bkozan21/calico-keyboard/3d_files/README.md

# 3d files
Here you can find the STEP and STL files for the case of the keyboard. The bottom and top layer are for the left side. For the right side, you can just mirror it in the slicer you are using.

I designed everything in onshape. The document is public. You can view it here: https://cad.onshape.com/documents/db90108e0c18a49f77f814f0/w/d8d8382bf78da29ebfbabf1b/e/875cb3c507a1a049483ec79f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
