bkozan21/calico-keyboard/3d_files/top layer.step

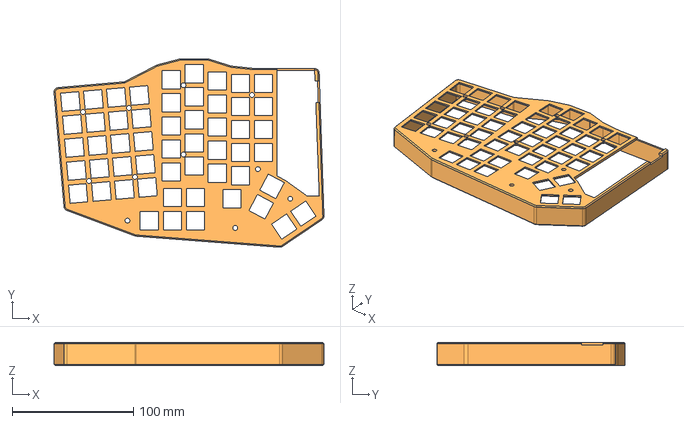
[picture p42: CAD file, 2026-11-06]
3d_files/top layer.step
222.3 x 155.2 x 19.0 mm
