bkozan21/calico-keyboard/3d_files/spacer.step

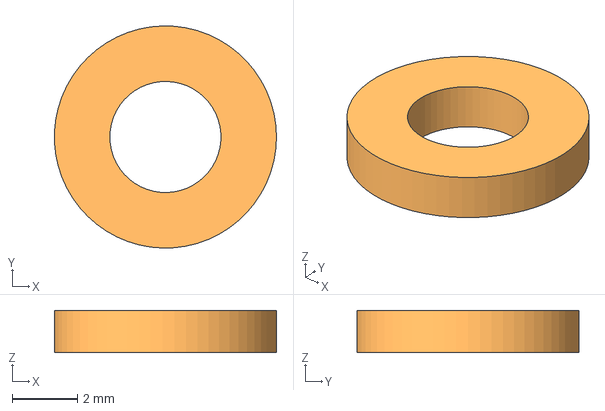
[picture p43: CAD file, 2026-11-06]
3d_files/spacer.step
6.80 x 6.80 x 1.30 mm
