bkozan21/calico-keyboard/3d_files/bottom layer.step

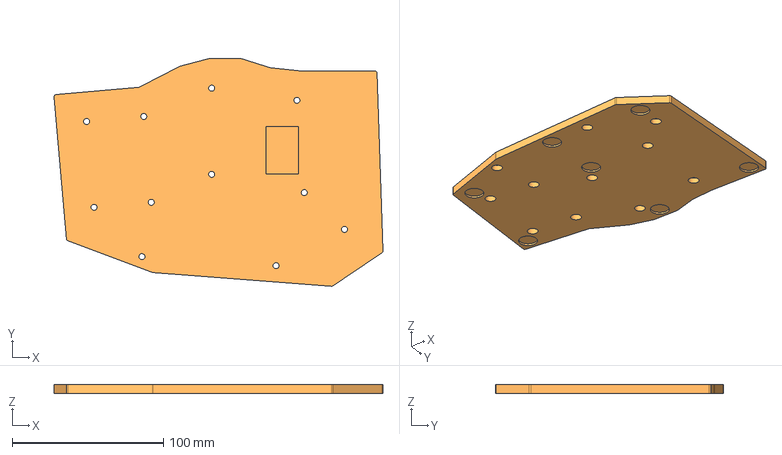
[picture p44: CAD file, 2026-11-06]
3d_files/bottom layer.step
217.7 x 150.6 x 6.00 mm
