bkozan21/calico-keyboard/(list of files, cad)

Other CAD files:
3d_files/bottom layer.stl
3d_files/spacer.stl
3d_files/top layer.stl
