bkozan21/calico-keyboard/pcb/ergogen_output.kicad_pcb

## KiCad design pcb/ergogen_output.kicad_pcb (2026-11-06)

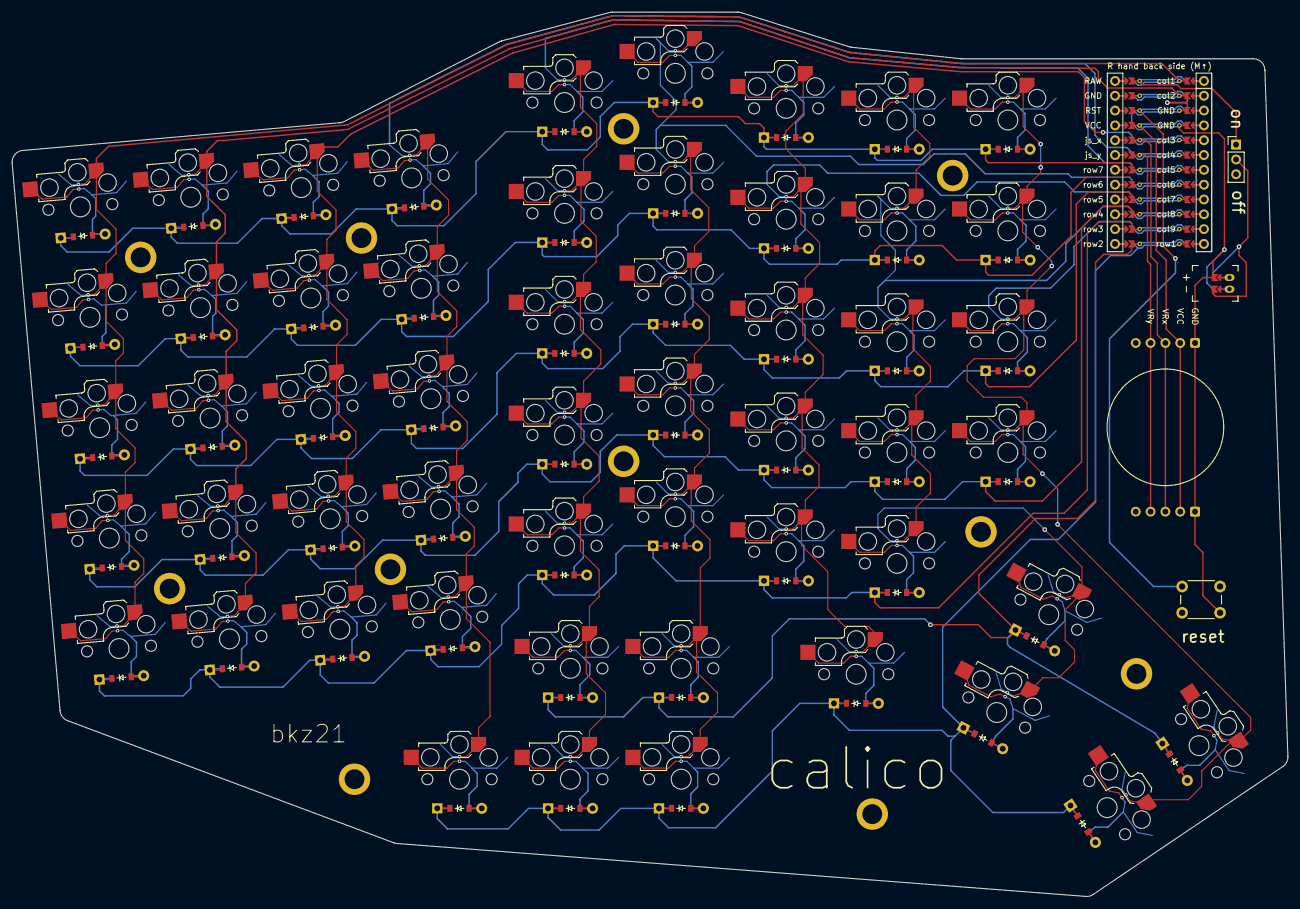
[picture p45: board ergogen_output.kicad_pcb from above]

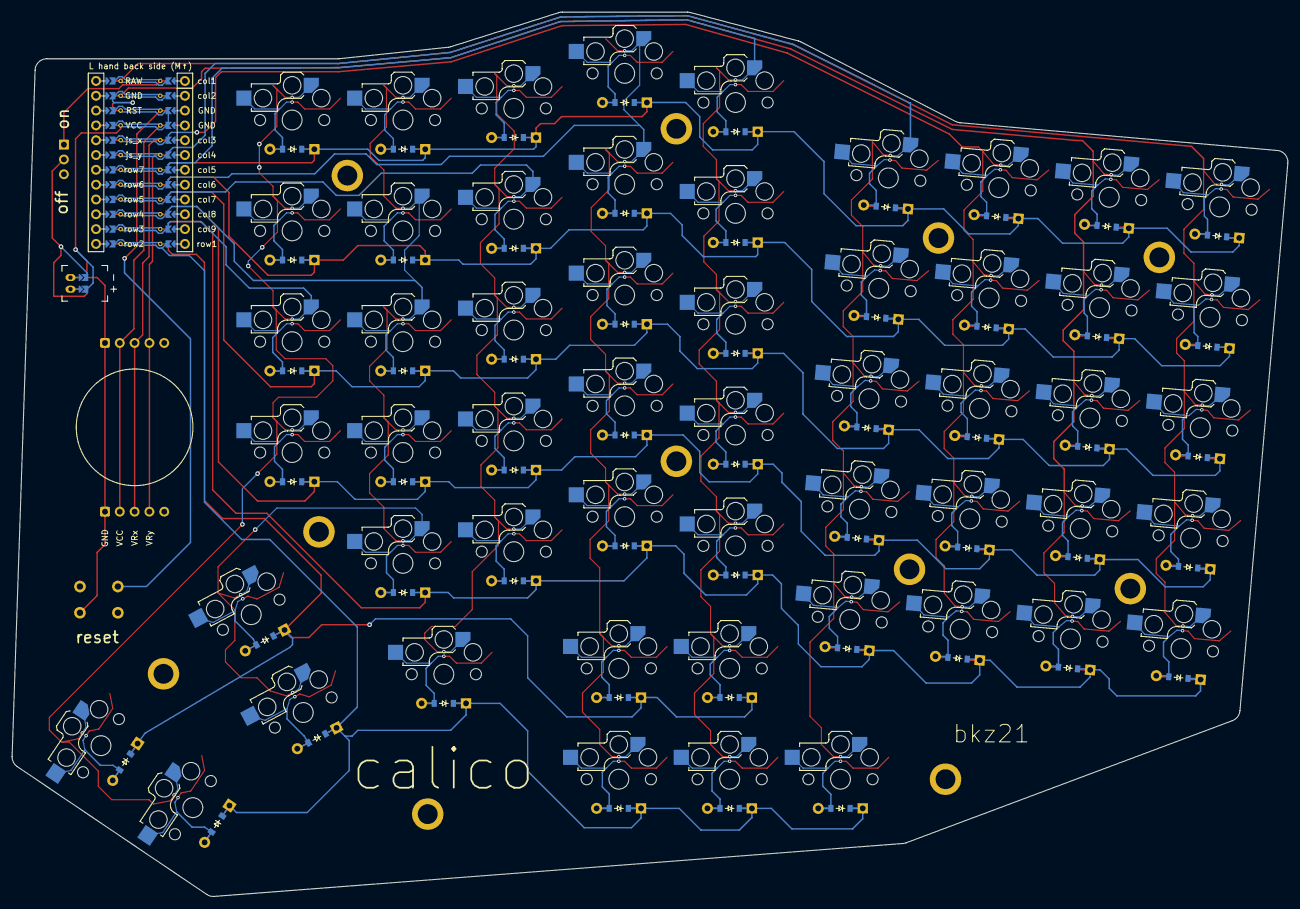
[picture p46: board ergogen_output.kicad_pcb from below]

Board: 2 copper layers, 218.7 x 151.6 mm, 121 parts (54 on the bottom side), 73 nets.

Parts:
D1, D2, D3, D4, D5, D6, D7, D8, D9, D10, D11, D12, D13, D14, D15, D16, D17, D18, D19, D20, D21, D22, D23, D24, D25, D26, D27, D28, D29, D30, D31, D32, D33, D34, D35, D36, D37, D38, D39, D40, D41, D42, D43, D44, D45, D46, D47, D48, D49, D50, D51, D52, D53, D54: diode_tht_sod123
H1, H2, H3, H4, H5, H6, H7, H8, H9, H10, H11: mounting_hole_plated
JST1: battery_connector_jst_ph_2
MCU1: mcu_nice_nano
S1, S2, S3, S4, S5, S6, S7, S8, S9, S10, S11, S12, S13, S14, S15, S16, S17, S18, S19, S20, S21, S22, S23, S24, S25, S26, S27, S28, S29, S30, S31, S32, S33, S34, S35, S36, S37, S38, S39, S40, S41, S42, S43, S44, S45, S46, S47, S48, S49, S50, S51, S52, S53, S54: switch_choc_v1_v2

Connections:
GND: JST1.1, MCU1.103, MCU1.104, MCU1.123
JST1_1: JST1.11, JST1.21, JST1.31
JST1_2: JST1.12, JST1.22, JST1.32
arrows_left_arrows_bottom: D50.2, S50.2
arrows_middle_arrows_bottom: D51.2, S51.2
arrows_middle_arrows_top: D52.2, S52.2
arrows_right_arrows_bottom: D53.2, S53.2
arrows_right_arrows_top: D54.2, S54.2
col1: MCU1.101, S1.1, S2.1, S3.1, S4.1, S5.1
col2: MCU1.102, S6.1, S7.1, S8.1, S9.1, S10.1
col3: MCU1.105, S11.1, S12.1, S13.1, S14.1, S15.1
col4: MCU1.106, S16.1, S17.1, S18.1, S19.1, S20.1, S50.1
col5: MCU1.107, S21.1, S22.1, S23.1, S24.1, S25.1, S51.1, S52.1
col6: MCU1.108, S26.1, S27.1, S28.1, S29.1, S30.1, S53.1, S54.1
col7: MCU1.109, S31.1, S32.1, S33.1, S34.1, S35.1, S45.1
col8: MCU1.110, S36.1, S37.1, S38.1, S39.1, S40.1, S46.1, S47.1
col9: MCU1.111, S41.1, S42.1, S43.1, S44.1, S48.1, S49.1
extra1_bottom: D11.2, S11.2
extra1_functions: D15.2, S15.2
extra1_home: D12.2, S12.2
extra1_numbers: D14.2, S14.2
extra1_top: D13.2, S13.2
extra2_bottom: D6.2, S6.2
extra2_functions: D10.2, S10.2
extra2_home: D7.2, S7.2
extra2_numbers: D9.2, S9.2
extra2_top: D8.2, S8.2
extra3_bottom: D1.2, S1.2
extra3_functions: D5.2, S5.2
extra3_home: D2.2, S2.2
extra3_numbers: D4.2, S4.2
extra3_top: D3.2, S3.2
far_thumb: D48.2, S48.2
far_thumb_up: D49.2, S49.2
home_thumb: D46.2, S46.2
home_thumb_up: D47.2, S47.2
index_bottom: D31.2, S31.2
index_functions: D35.2, S35.2
index_home: D32.2, S32.2
index_numbers: D34.2, S34.2
index_top: D33.2, S33.2
inner1_bottom: D36.2, S36.2
inner1_functions: D40.2, S40.2
inner1_home: D37.2, S37.2
inner1_numbers: D39.2, S39.2
inner1_top: D38.2, S38.2
inner2_functions: D44.2, S44.2
inner2_home: D41.2, S41.2
inner2_numbers: D43.2, S43.2
inner2_top: D42.2, S42.2
middle_bottom: D26.2, S26.2
middle_functions: D30.2, S30.2
middle_home: D27.2, S27.2
middle_numbers: D29.2, S29.2
middle_top: D28.2, S28.2
near_thumb: D45.2, S45.2
pinky_bottom: D16.2, S16.2
pinky_functions: D20.2, S20.2
pinky_home: D17.2, S17.2
pinky_numbers: D19.2, S19.2
pinky_top: D18.2, S18.2
ring_bottom: D21.2, S21.2
ring_functions: D25.2, S25.2
ring_home: D22.2, S22.2
ring_numbers: D24.2, S24.2
ring_top: D23.2, S23.2
row1: D45.1, D46.1, D48.1, D50.1, D51.1, D53.1, MCU1.112
row2: D47.1, D49.1, D52.1, D54.1, MCU1.113
row3: D1.1, D6.1, D11.1, D16.1, D21.1, D26.1, D31.1, D36.1, MCU1.114
row4: D2.1, D7.1, D12.1, D17.1, D22.1, D27.1, D32.1, D37.1, D41.1, MCU1.115
row5: D3.1, D8.1, D13.1, D18.1, D23.1, D28.1, D33.1, D38.1, D42.1, MCU1.116
row6: D4.1, D9.1, D14.1, D19.1, D24.1, D29.1, D34.1, D39.1, D43.1, MCU1.117
row7: D5.1, D10.1, D15.1, D20.1, D25.1, D30.1, D35.1, D40.1, D44.1, MCU1.118
