bkozan21/calico-keyboard/(commit log)

2026-11-06 added pcb files
    [ergogen_output.kicad_pcb, ergogen_output.kicad_sch]
2026-11-06 added 3d files
    [bottom layer.step, bottom layer.stl, spacer.step, spacer.stl, top layer.step, top layer.stl]
2026-11-06 added gerber files
    [ergogen_output-B_Cu.gbr, ergogen_output-B_Mask.gbr, ergogen_output-B_Paste.gbr, ergogen_output-B_Silkscreen.gbr, ergogen_output-Edge_Cuts.gbr, ergogen_output-F_Cu.gbr, ergogen_output-F_Mask.gbr, ergogen_output-F_Paste.gbr]
