bkozan21/calico-keyboard/Split Keyboard/IMG_8234.jpeg

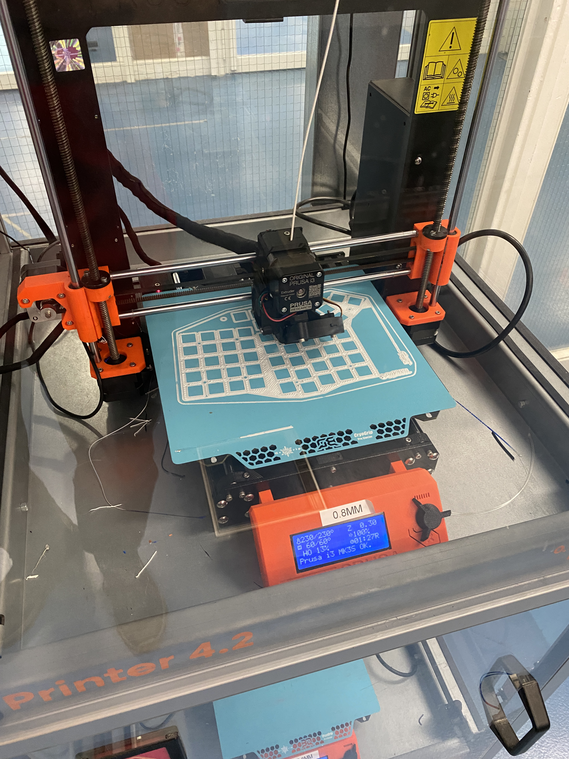
[picture p24: Split Keyboard/IMG_8234.jpeg]
Split Keyboard/IMG_8234.jpeg
